georgeredinger/nRF51822/README.md

nRF51822
========

Diseño del Módulo nRF51822
