georgeredinger/nRF51822/BOM_nRF51822.xlsx

Sheet: Lista Materiales Sugeridos
nRF51822
Qty | Value | Device | Parts | Part ID | Distribuitor | Distribuitor Part | Stock | U Price | T Price | Link | Notas
1 | 16MHz | 2.5X2MM | X1 | NX2520SA-16MHZ-STD-CSW-5 | Digikey | 644-1169-1-ND | 1674 | 1.62 |  | http://www.digikey.com/product-detail/en/NX2520SA-16MHZ-STD-CSW-5/644-1169-1-ND/3125558 | N/A
 |  |  |  | ABM10-16.000MHZ-E20-T | Mouser | 815-ABM10-16-E20-T | 1759 | 2.54 |  | http://mx.mouser.com/ProductDetail/ABRACON/ABM10-16000MHZ-E20-T/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 | 10pF vs 8pF
 |  |  |  | ABM10-16.000MHZ-E20-T | Digikey | 535-9810-1-ND | 3243 | 2.44 |  | http://www.digikey.com/product-detail/en/ABM10-16.000MHZ-E20-T/535-9810-1-ND/2001433 | 10pF vs 8pF
 |  |  |  | 8Z-16.000MEEQ-T | Mouser | 717-8Z-16.000MEEQ-T | 3766 | 3.65 |  | http://mx.mouser.com/ProductDetail/TXC-Corporation/8Z-16000MEEQ-T/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 | N/A
1 | BAT_HOLDER | BK-912 | BAT_HOLDER | BK-912 | Digikey | BK-912-ND | 19369 | 0.32 |  | http://www.digikey.com/scripts/DkSearch/dksus.dll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 | N/A
 |  |  |  | BAT-HLD-001 | Mouser | 712-BAT-HLD-001 | 26890 | 0.351 |  | http://mx.mouser.com/Search/ProductDetail.aspx?qs=K5ta8V%252bWhta7hbVGfm4dqA%3d%3d | N/A
 |  |  |  | BAT-HLD-001 | Digikey | BAT-HLD-001-ND | 37903 | 0.27 |  | http://www.digikey.com/scripts/DkSearch/dksus.dll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 | N/A
1 | ANT | CHIP_ANTENNA | ANT | 2450AT18B100E | Mouser | 609-2450AT18B100E | 5517 | 1.21 |  | http://mx.mouser.com/search/ProductDetail.aspx?qs=yCnrNFeXz%252bh5MFsFIXGZGA== | N/A
 |  |  |  | 2450AT18B100E | Digikey | 712-1006-1-ND | 10828 | 0.94 |  | http://www.digikey.com/product-detail/en/2450AT18B100E/712-1006-1-ND/1560835 | N/A
1 | BAT165 | BAT165 | D1 | BAT 165 E6327 | Mouser | 726-BAT165E6327 | 9000 | 0.702 |  | http://mx.mouser.com/search/ProductDetail.aspx?qs=mzcOS1kGbgcQqWsJMFtrug== | N/A
 |  |  |  | BAT 165 E6327 | Digikey | BAT 165 E6327CT-ND | 1619 | 0.55 |  | http://www.digikey.com/product-detail/en/BAT%20165%20E6327/BAT%20165%20E6327CT-ND/3819504 | N/A
1 | BALUM | BALUM | BALUM | 2450BM14A0002T | Mouser | 609-2450BM14A0002T | 3773 | 1.91 |  | http://mx.mouser.com/search/ProductDetail.aspx?qs=yCnrNFeXz%252bjc2NrpGmrycg== | N/A
2 | SWITCH | SWITCH | SW | B3U-1000P | Mouser | 653-B3U-1000P | 23823 | 1.34 |  | http://mx.mouser.com/search/ProductDetail.aspx?qs=AO7BQMcsEu4ip80xyf2FwA== | N/A
 |  |  |  | B3U-1000P | Digikey | SW1020CT-ND | 44492 | 1.25 |  | http://www.digikey.com/product-detail/en/B3U-1000P/SW1020CT-ND/1534357 | N/A
1 | CON_PROG | CON_PROG | CON_PROG | GRPB052VWQS-RC | Digikey | S9012E-05-ND | 14569 | 1.14 |  | http://www.digikey.com/product-detail/en/GRPB052VWQS-RC/S9012E-05-ND/1786414 | N/A
 |  |  |  | M50-3600542 | Mouser | 855-M50-3600542 | 8296 | 1.98 |  | http://mx.mouser.com/ProductDetail/Harwin/M50-3600542/ | N/A
 |  |  |  | M50-3600542 | Digikey | 952-1389-ND | 5917 | 1.52 |  | http://www.digikey.com/scripts/DkSearch/dksus.dll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 | N/A
 |  |  |  | 20021121-00010C4LF | Mouser | 649-202112100010C4LF | 6244 | 1.24 |  | http://mx.mouser.com/ProductDetail/FCI/20021121-00010C4LF/ | N/A
 |  |  |  | 20021121-00010C4LF | Digikey | 609-3695-1-ND | 12947 | 1.13 |  | http://www.digikey.com/product-detail/en/20021121-00010C4LF/609-3695-1-ND/2209147 | N/A
2 | LED | LED0603 | LED | LTST-C191KGKT | Mouser | 859-LTST-C191KGKT | 51875 | 0.156 |  | http://mx.mouser.com/ProductDetail/Lite-On/LTST-C191KGKT/ | N/A
 |  |  |  | LTST-C191KGKT | Digikey | 160-1446-1-ND | 169248 | 0.32 |  | http://www.digikey.com/product-detail/en/LTST-C191KGKT/160-1446-1-ND/386834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 | N/A
 |  |  |  | TLMP1100-GS08 | Mouser | 78-TLMP1100-GS08 | 8302 | 0.715 |  | http://mx.mouser.com/ProductDetail/Vishay-Semiconductors/TLMP1100-GS08/ | N/A
 |  |  |  | TLMP1100-GS08 | Digikey | 751-1176-1-ND | 24586 | 0.6 |  | http://www.digikey.com/product-detail/en/TLMP1100-GS08/751-1176-1-ND/1681459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 | N/A
1 | CR2032 | BAT1 | BAT1 | CR2032 | Digikey | CR2032VP | 255106 | 0.4 |  | http://www.digikey.com/scripts/DkSearch/dksus.dll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 | N/A

Sheet: BOM_EAGLE
Comunicaciones
Qty | Value | Device | Parts | Part ID | Mouser Part | Stock | U Price | T Price | Link | Notas
2 |  | LED0603 | LED1, LED2 | LTST-C191KGKT | 859-LTST-C191KGKT | 51875 | 0.156 | 0.312 | http://mx.mouser.com/ProductDetail/Lite-On/LTST-C191KGKT/ | N/A
4 | 0.1uF | CAP0603-CAP | C10, C11, C3, C6 | C1608X7R1H104K | 810-C1608X7R1H104K | 226104 | 0.208 | 0.832 | http://mx.mouser.com/ProductDetail/TDK/C1608X7R1H104K/?qs=sGAEpiMZZMvQvaS66kI3TvHonbvhj0AsNgPMHD0N7kQ%3d | N/A
1 | 1nF | CAP0603-CAP | C5 | GRM1885C1H102FA01D | 81-GRM1885C1H102FA1D | 154885 | 0.13 | 0.13 | http://mx.mouser.com/ProductDetail/Murata-Electronics/GRM1885C1H102FA01D/ | N/A
1 | 1uF | CAP0603-CAP | C1 | C1608X5R1H105K | 810-C1608X5R1H105K | 57892 | 0.39 | 0.39 | http://mx.mouser.com/ProductDetail/TDK/C1608X5R1H105K/ | N/A
1 | 2.2nF | CAP0603-CAP | C12 | GRM1885C1H222JA01D | 81-GRM1885C1H222JA01 | 74134 | 0.156 | 0.156 | http://mx.mouser.com/ProductDetail/Murata-Electronics/GRM1885C1H222JA01D/ | N/A
2 | 4.7K | RESISTOR0603-RES | R4, R5 | ERJ-3EKF4701V | 667-ERJ-3EKF4701V | 68593 | 0.104 | 0.208 | http://mx.mouser.com/ProductDetail/Panasonic/ERJ-3EKF4701V/?qs=sGAEpiMZZMu61qfTUdNhG6gKAQVNBKOonW3iBDX7kM4%3d | N/A
1 | 4.7uF | CAP0603-CAP | C2 | C1608X5R1E475K | 810-C1608X5R1E475K | 9596 | 0.26 | 0.26 | http://mx.mouser.com/ProductDetail/TDK/C1608X5R1E475K/ | N/A
2 | 10K | RESISTOR0603-RES | R7, R9 | ERJ-3EKF1002V | 667-ERJ-3EKF1002V | 301704 | 0.104 | 0.208 | http://mx.mouser.com/ProductDetail/Panasonic/ERJ-3EKF1002V/ | N/A
1 | 10uF | CAP0603-CAP | C9 | C1608X5R1A106M | 810-C1608X5R1A106M | 178203 | 0.715 | 0.715 | http://mx.mouser.com/ProductDetail/TDK/C1608X5R1A106M/ | N/A
1 | 10uH | INDUCTOR0603 | L2 | BRL1608T100M | 963-BRL1608T100M | 17459 | 0.403 | 0.403 | http://mx.mouser.com/ProductDetail/Taiyo-Yuden/BRL1608T100M/ | N/A
1 | 12K | RESISTOR0603-RES | R1 | ERJ-3EKF1202V | 667-ERJ-3EKF1202V | 63455 | 0.104 | 0.104 | http://mx.mouser.com/ProductDetail/Panasonic-Electronic-Components/ERJ-3EKF1202V/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 | N/A
4 | 12pF | CAP0603-CAP | C7, C8, C13, C14 | 06035A120FAT2A | 581-06035A120FAT2A | 7290 | 0.39 | 1.56 | http://mx.mouser.com/ProductDetail/AVX/06035A120FAT2A/ | N/A
1 | 15nH | INDUCTOR0603 | L1 | LQW18AN15NJ00D | 81-LQW18AN15NJ00D | 6974 | 0.429 | 0.429 | http://mx.mouser.com/ProductDetail/Murata-Electronics/LQW18AN15NJ00D/ | N/A
1 | 20mm coincell | BATTERY20MM_4LEGS_OVERPASTE | BATT | BAT-HLD-001 | 712-BAT-HLD-001 | 26890 | 0.351 | 0.351 | http://mx.mouser.com/Search/ProductDetail.aspx?qs=K5ta8V%252bWhta7hbVGfm4dqA%3d%3d | N/A
1 | 47nF | CAP0603-CAP | C4 | GRM188R71H473KA61D | 81-GRM188R71H473KA61 | 247696 | 0.156 | 0.156 | http://mx.mouser.com/ProductDetail/Murata-Electronics/GRM188R71H473KA61D/ | N/A
4 | 150 | RESISTOR0603-RES | R2, R3, R6, R8 | ERJ-3EKF1500V | 667-ERJ-3EKF1500V | 29791 | 0.104 | 0.416 | http://mx.mouser.com/ProductDetail/Panasonic/ERJ-3EKF1500V/?qs=sGAEpiMZZMvdGkrng054t5J98uyV6qJ9ZdXNjSb2Hxw%3d | N/A
1 | ANTENA-2450AT | ANTENA-2450AT | ANT | 2450AT18B100E | 609-2450AT18B100E | 5517 | 1.21 | 1.21 | http://mx.mouser.com/search/ProductDetail.aspx?qs=yCnrNFeXz%252bh5MFsFIXGZGA== | N/A
1 | BALUN-2450BM | BALUN-2450BM | BLN | 2450BM14A0002T | 609-2450BM14A0002T | 3773 | 1.91 | 1.91 | http://mx.mouser.com/search/ProductDetail.aspx?qs=yCnrNFeXz%252bjc2NrpGmrycg== | N/A
2 | BC847 | BC847 | T1, T2 | BC847BLT1G | 863-BC847BLT1G | 35980 | 0.182 | 0.364 | http://mx.mouser.com/ProductDetail/ON-Semiconductor/BC847BLT1G/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 | N/A
1 | CM | JUMP_SMDPITCH_0.05 | JP1 | M50-3600542 | 855-M50-3600542 | 8296 | 1.98 | 1.98 | http://mx.mouser.com/ProductDetail/Harwin/M50-3600542/ | N/A
1 | CRYSTAL.ABS07 | CRYSTAL.ABS07 | Y1 | ABS07-32.768KHZ-9-T | 815-ABS07-32.768K9T | 1782 | 1.86 | 1.86 | http://mx.mouser.com/ProductDetail/ABRACON/ABS07-32768KHZ-9-T/ | N/A
1 | CRYSTAL2.5X2 | CRYSTAL2.5X2 | XT | ABM10-16.000MHZ-E20-T | 815-ABM10-16-E20-T | 1759 | 2.54 | 2.54 | http://mx.mouser.com/ProductDetail/ABRACON/ABM10-16000MHZ-E20-T/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 | N/A
1 | NRF51822 | NRF51822 | NRF51822 |  |  |  |  | 0
1 | PROG-JLINK-SEAGGER | PROG-JLINK-SEAGGER | PROG | M50-3600542 | 855-M50-3600542 | 8296 | 1.98 | 1.98 | http://mx.mouser.com/ProductDetail/Harwin/M50-3600542/ | N/A
2 | SWITCH_SMD_BB | SWITCH_SMD_BB | SW1, SW2 | B3U-1000P | 653-B3U-1000P | 23823 | 1.34 | 2.68 | http://mx.mouser.com/search/ProductDetail.aspx?qs=AO7BQMcsEu4ip80xyf2FwA== | N/A
1 | VCC_PROG | JUMP_SMDPITCH_0.05 | JP2 | M50-3600542 | 855-M50-3600542 | 8296 | 1.98 | 1.98 | http://mx.mouser.com/ProductDetail/Harwin/M50-3600542/ | N/A
2 | JUMPER | JUMPER | JUMPER | M50-1900005 | 855-M50-1900005 | 13010 | 0.819 | 1.638 | http://mx.mouser.com/ProductDetail/Harwin/M50-1930005/ | N/A
 |  |  |  |  |  |  | Total | 24.772
