georgeredinger/nRF51822/nRF51822.brd

## EAGLE design nRF51822.brd (2013-08-01)

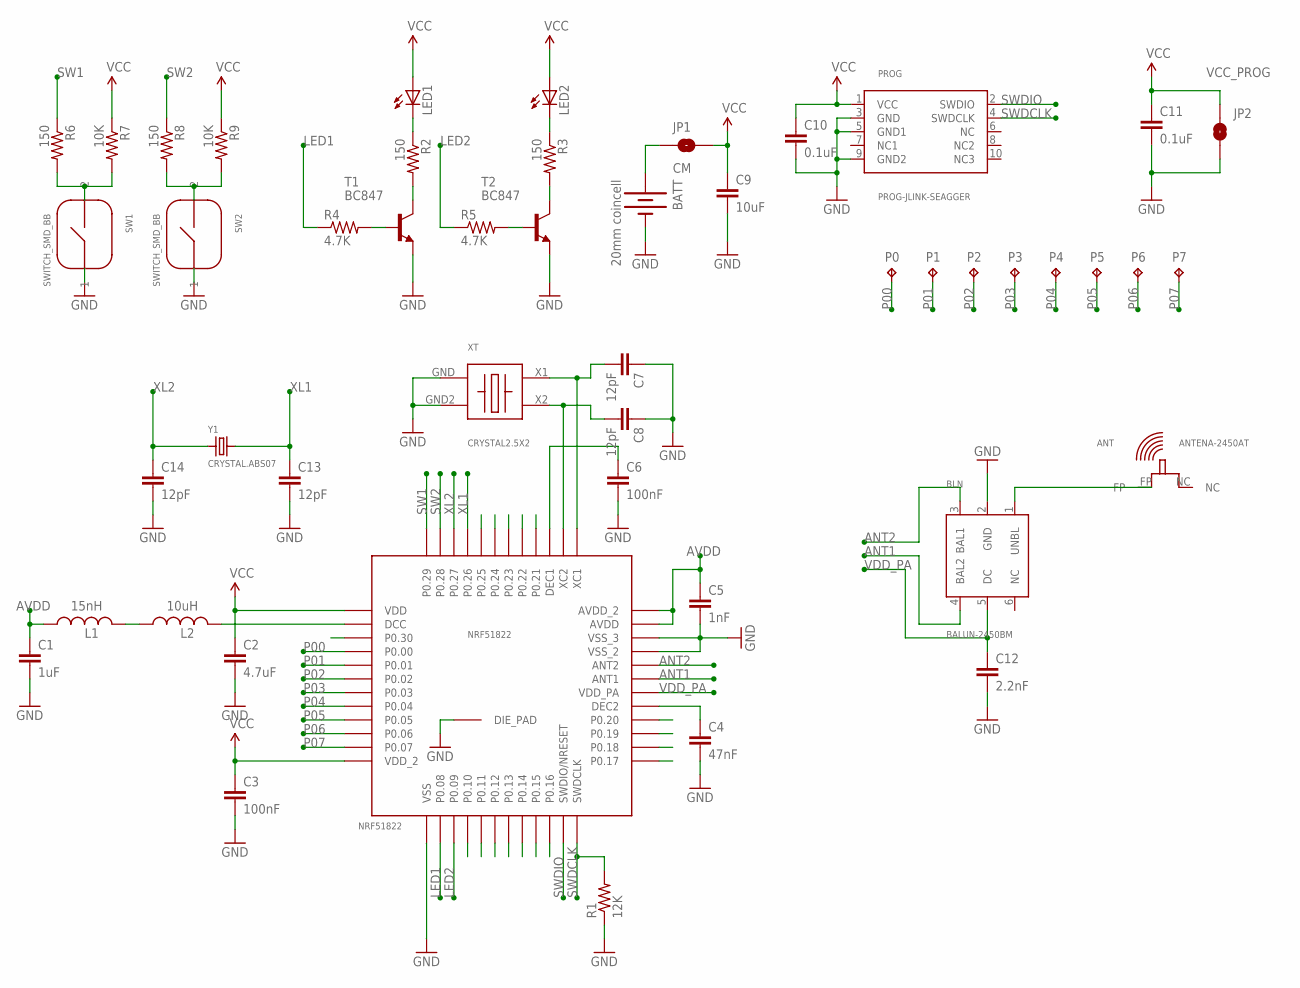
[picture p1: schematic nRF51822.sch]

Parts:
ANT: ANTENA-2450AT; 2450AT18B100
BATT: 20mm coincell; BATTCON_20MM_4LEGS_OVERPASTE
BLN: BALUN-2450BM; 2450BM14A0002
C1: 1uF; 0603-CAP
C2: 4.7uF; 0603-CAP
C3, C6: 100nF; 0603-CAP
C4: 47nF; 0603-CAP
C5: 1nF; 0603-CAP
C7, C8, C13, C14: 12pF; 0603-CAP
C9: 10uF; 0603-CAP
C10, C11: 0.1uF; 0603-CAP
C12: 2.2nF; 0603-CAP
JP1: CM; JUMP-0.05-SMD
JP2: VCC_PROG; JUMP-0.05-SMD
L1: 15nH; 0603
L2: 10uH; 0603
LED1, LED2: LED0603; LED-0603
NRF51822: NRF51822; QFN48
P0, P1, P2, P3, P4, P5, P6, P7: TPB1,27; B1,27
PROG: PROG-JLINK-SEAGGER; M50-3600742
R1: 12K; 0603-RES
R2, R3, R6, R8: 150; 0603-RES
R4, R5: 4.7K; 0603-RES
R7, R9: 10K; 0603-RES
SW1, SW2: SWITCH_SMD_BB; SWITCH3X2.5
T1, T2: BC847; SOT23
XT: CRYSTAL2.5X2; 2.5X2MM
Y1: CRYSTAL.ABS07; ABS07

Connections:
ANT1: BLN.4 (BAL2), NRF51822.31 (ANT1)
ANT2: BLN.3 (BAL1), NRF51822.32 (ANT2)
AVDD: C1.1, C5.1, L1.1, NRF51822.35 (AVDD), NRF51822.36 (AVDD_2)
GND: BATT.2 (-), BLN.2 (GND), C1.2, C2.2, C3.2, C4.2, C5.2, C6.2, C7.1, C8.1, C9.2, C10.2, C11.2, C12.2, C13.2, C14.2, JP2.P$2 (2), NRF51822.13 (VSS), NRF51822.33 (VSS_2), NRF51822.34 (VSS_3), NRF51822.GND (DIE_PAD), PROG.3 (GND), PROG.5 (GND1), PROG.9 (GND2), R1.1, SW1.1, SW2.1, T1.2 (E), T2.2 (E), XT.GND, XT.GND2
LED1: NRF51822.14 (P0.08), R4.1
LED2: NRF51822.15 (P0.09), R5.1
unnamed: C6.1, NRF51822.39 (DEC1)
unnamed: L1.2, L2.1
unnamed: L2.2, NRF51822.2 (DCC)
unnamed: C8.2, NRF51822.38 (XC2), XT.X2
unnamed: C7.2, NRF51822.37 (XC1), XT.X1
unnamed: C4.1, NRF51822.29 (DEC2)
unnamed: R5.2, T2.1 (B)
unnamed: BATT.1 (+), JP1.P$1 (1)
unnamed: R3.2, T2.3 (C)
unnamed: LED2.C, R3.1
unnamed: R8.2, R9.2, SW2.2
unnamed: R2.2, T1.3 (C)
unnamed: ANT.FP, BLN.1 (UNBL)
unnamed: LED1.C, R2.1
unnamed: R4.2, T1.1 (B)
unnamed: R6.2, R7.2, SW1.2
P00: NRF51822.4 (P0.00), P0.TP
P01: NRF51822.5 (P0.01), P1.TP
P02: NRF51822.6 (P0.02), P2.TP
P03: NRF51822.7 (P0.03), P3.TP
P04: NRF51822.8 (P0.04), P4.TP
P05: NRF51822.9 (P0.05), P5.TP
P06: NRF51822.10 (P0.06), P6.TP
P07: NRF51822.11 (P0.07), P7.TP
SW1: NRF51822.48 (P0.29), R6.1
SW2: NRF51822.47 (P0.28), R8.1
SWDCLK: NRF51822.24 (SWDCLK), PROG.4 (SWDCLK), R1.2
SWDIO: NRF51822.23 (SWDIO/NRESET), PROG.2 (SWDIO)
VCC: C2.1, C3.1, C9.1, C10.1, C11.1, JP1.P$2 (2), JP2.P$1 (1), LED1.A, LED2.A, NRF51822.1 (VDD), NRF51822.12 (VDD_2), PROG.1 (VCC), R7.1, R9.1
VDD_PA: BLN.5 (DC), C12.1, NRF51822.30 (VDD_PA)
XL1: C13.1, NRF51822.45 (P0.26), Y1.2
XL2: C14.1, NRF51822.46 (P0.27), Y1.1

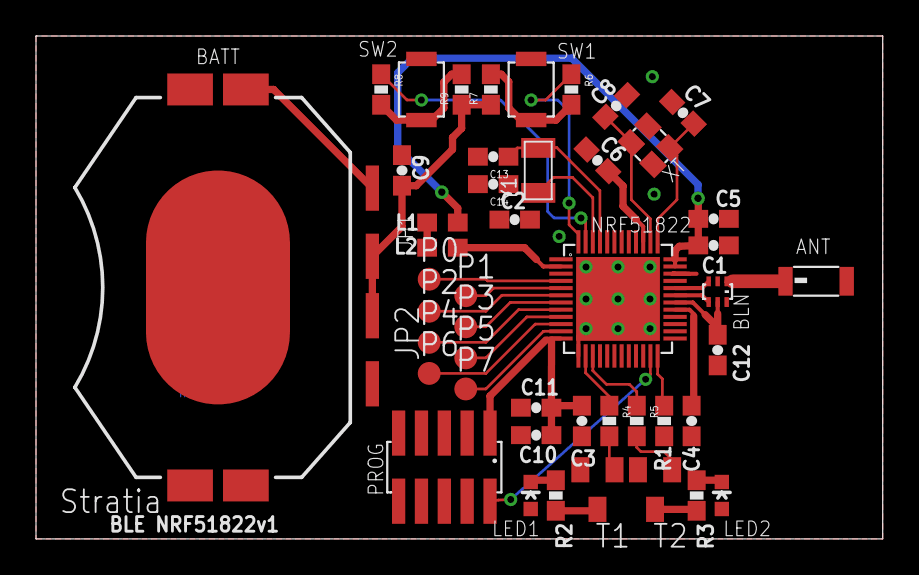
[picture p2: board nRF51822.brd from above]

Board: 2 copper layers, 47.0 x 27.9 mm, 48 parts (0 on the bottom side), 38 nets.
