georgeredinger/nRF51822/(commit log)

2013-07-09 Diseno listo Esquematico
    [nRF51822.sch]
2013-07-09 anadi una tierra para test
2013-07-09 Nordic51822 Footprint
2013-07-09 BOM nRF51822
    [BOM_nRF51822.xlsx]
2013-07-09 Update nRF51822 device
    [nRF51822.brd, nRF51822.sch]
2013-07-09 CRYSTAL 16MHz Footprint
2013-07-09 Agregado de mas modulos
    Agregado Leds, Switchs y Alimentación
    [BOM_nRF51822.xlsx, nRF51822.brd, nRF51822.sch]
2013-07-10 Update Library
    Crystal, Conector de Programacion, Conector IO, Balun, Antena
2013-07-10 Update BOM
    [BOM_nRF51822.xlsx, nRF51822.brd, nRF51822.sch]
2013-07-10 Terminado el Esquemático
    [BOM_nRF51822.xlsx, nRF51822.brd, nRF51822.sch]
2013-07-10 Correccion Capacitores
    Correccion de los capacitores C1 y C2 del Crystal
    [nRF51822.brd, nRF51822.sch]
2013-07-10 Tamaño de Letras
    [nRF51822.sch]
2013-07-11 Board 90%
    [nRF51822.brd, nRF51822.sch]
2013-07-11 BOM 50%
    [BOM_nRF51822.xlsx]
2013-07-12 BLE NRF51822v1
    Board 100%, Lbr update Top places
    [nRF51822.brd, nRF51822.sch]
2013-07-15 Gerber Files
    [BOM_nRF51822.xlsx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]
2013-07-25 BOM Update
    [BOM_nRF51822.xlsx]
2013-07-25 Esquemático Rev 2
    [nRF51822.brd, nRF51822.sch]
2013-08-01 Board V2 - 85%
    [nRF51822.brd, nRF51822.sch]
2013-08-01 BOM Updated
    [BOM_nRF51822.xlsx]
